D-T-12/Robot-Project-2019/README.md

# Robot-Project-2019
This is the Repo for the work complete during the 2019 Lancaster University Robot Project by Group U. 

The project was complete as part of a Mechatronnic Engineering Master's Degree.

The robot completed the task of following a line and posting a letter. 

The working code, final report and video of the final testing of the robot are contained within this repo.
